geschwint/AEG_Micromat/Original Hardware/Control Comp. Side 2.jpg

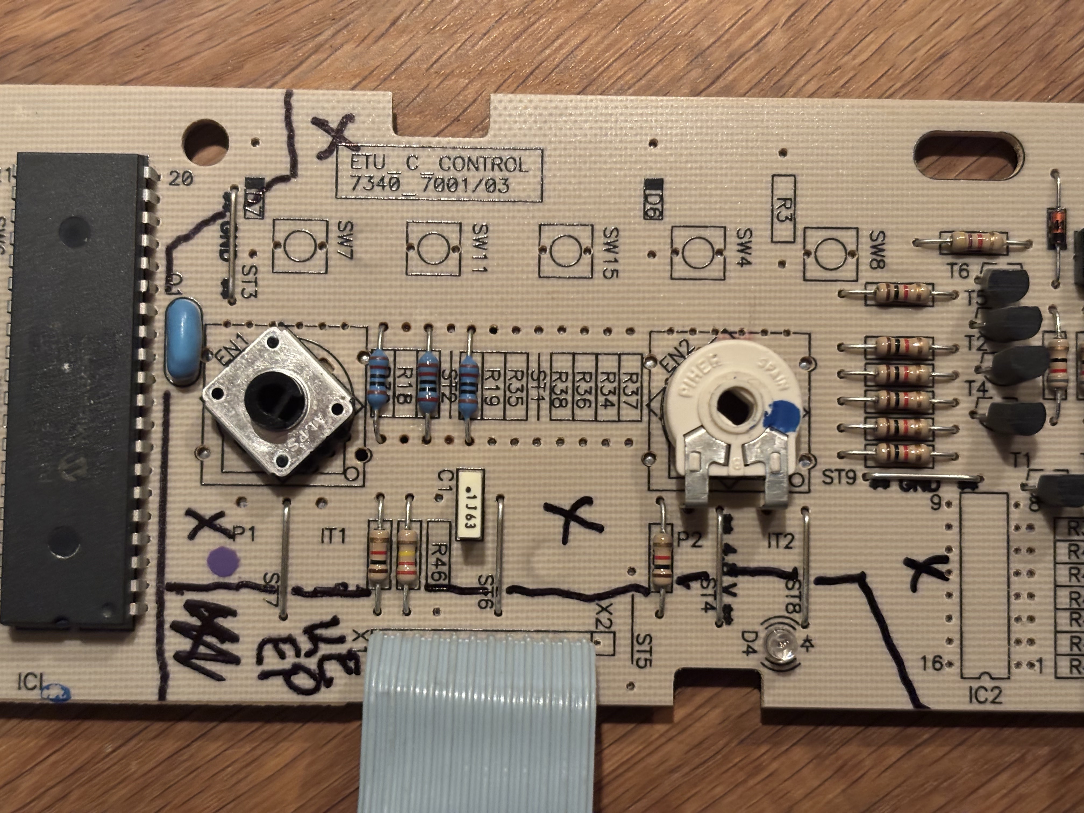
Original Hardware/Control Comp. Side 2.jpg
