geschwint/AEG_Micromat/Original Hardware/Panel.jpg

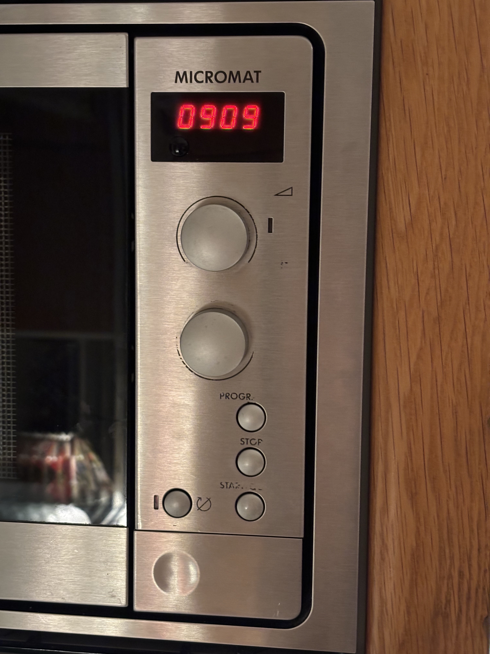
Original Hardware/Panel.jpg
