geschwint/AEG_Micromat/AboutTheMicro.jpg

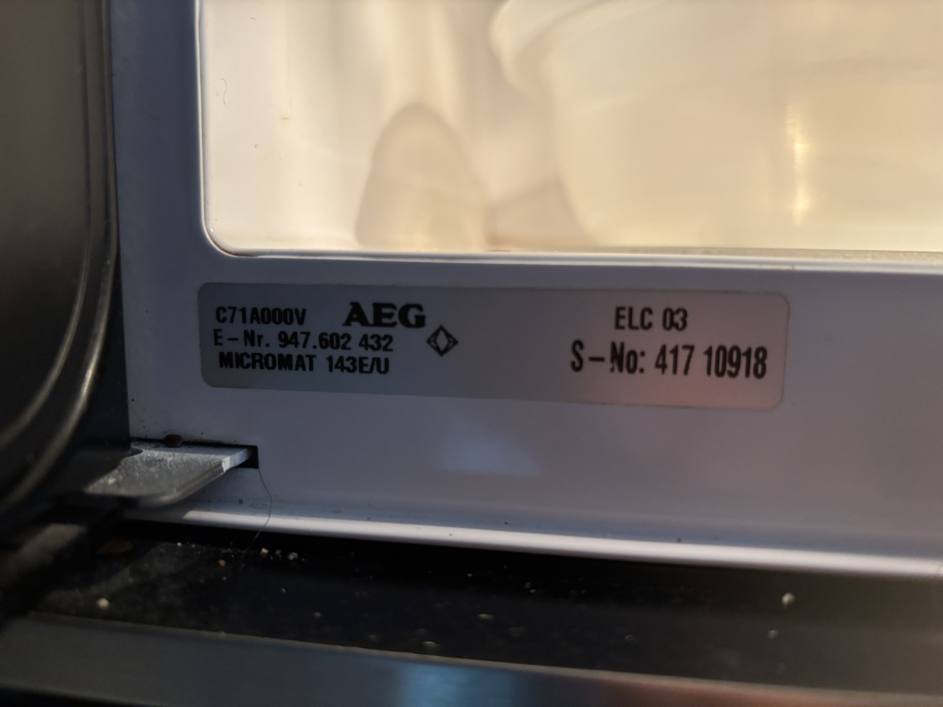
AboutTheMicro.jpg
