geschwint/AEG_Micromat/Original Hardware/Backside Panel Display, Encoder and Pot.jpg

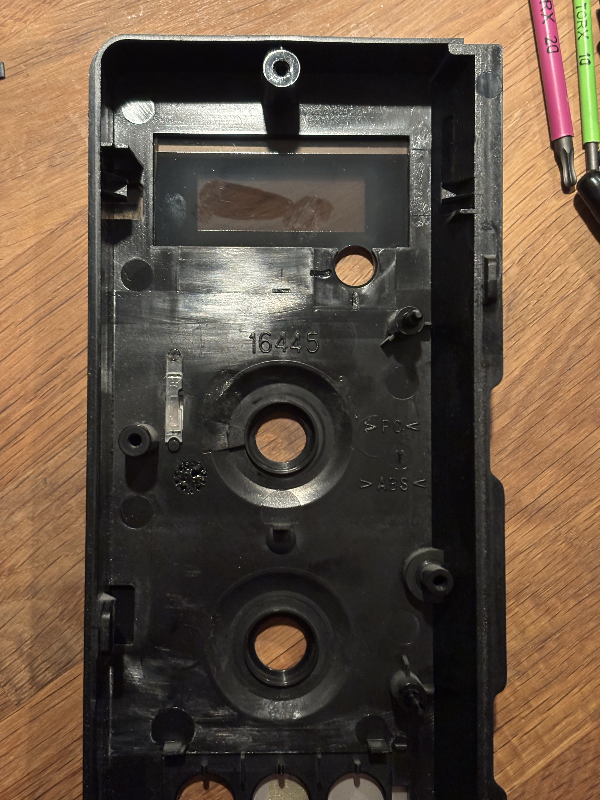
Original Hardware/Backside Panel Display, Encoder and Pot.jpg
