geschwint/AEG_Micromat/Original Hardware/Bakside Panel Buttons.jpg

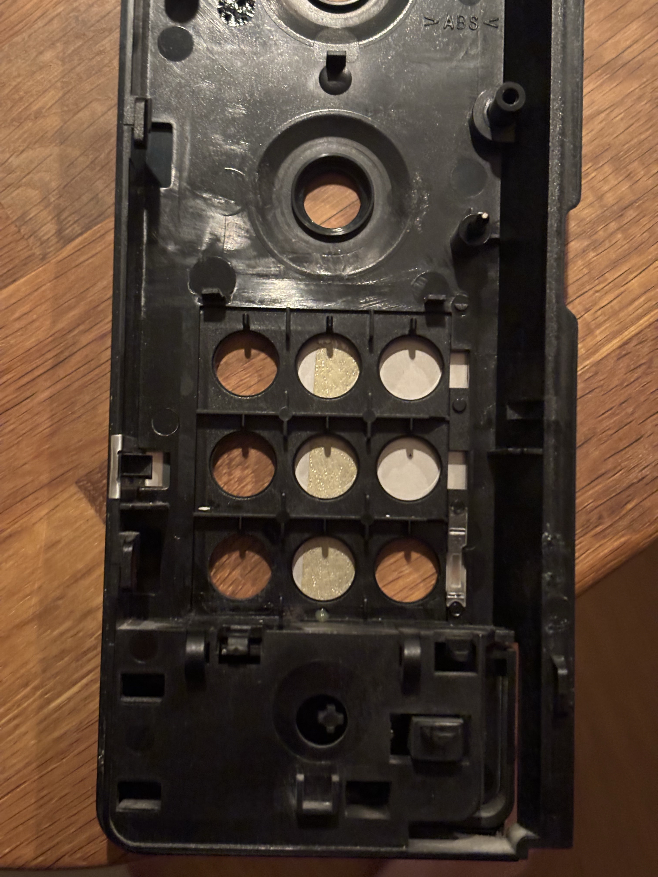
Original Hardware/Bakside Panel Buttons.jpg
