geschwint/AEG_Micromat/Original Hardware/Cables.jpg

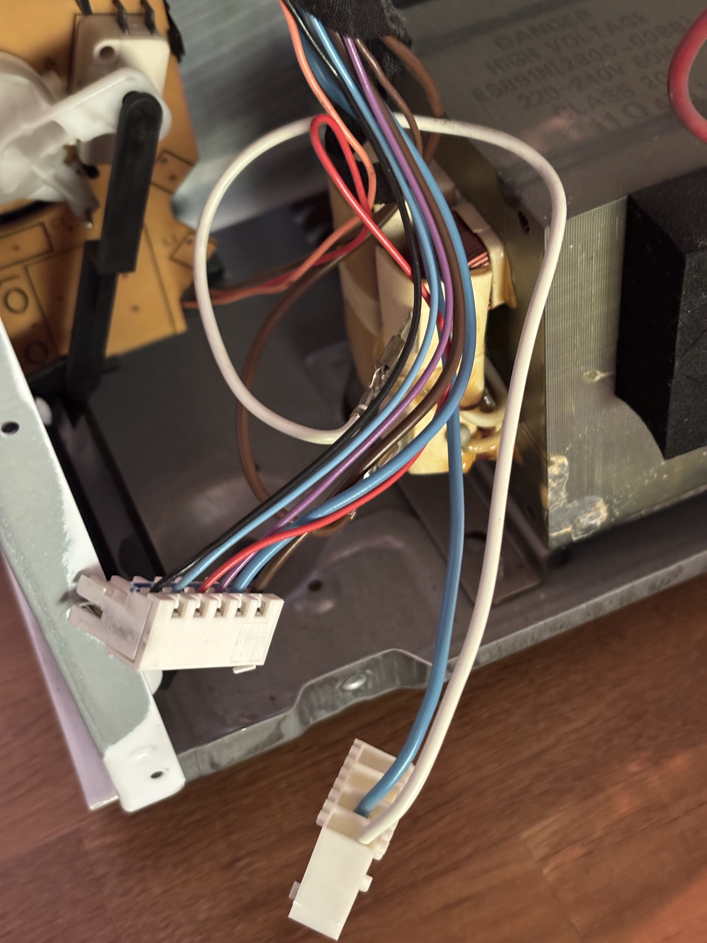
Original Hardware/Cables.jpg
