geschwint/AEG_Micromat/Original Hardware/Control Comp. Side 1.jpg

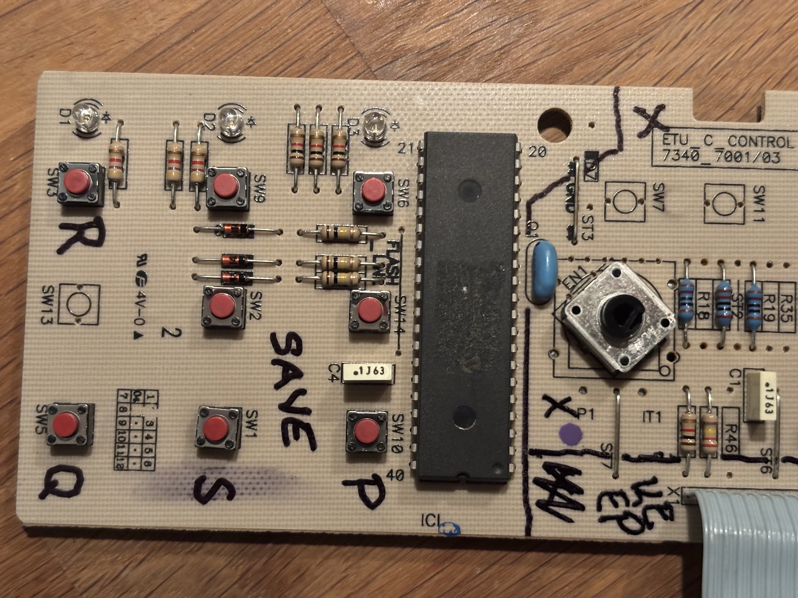
Original Hardware/Control Comp. Side 1.jpg
