geschwint/AEG_Micromat/Original Hardware/Control Comp. Side 3.jpg

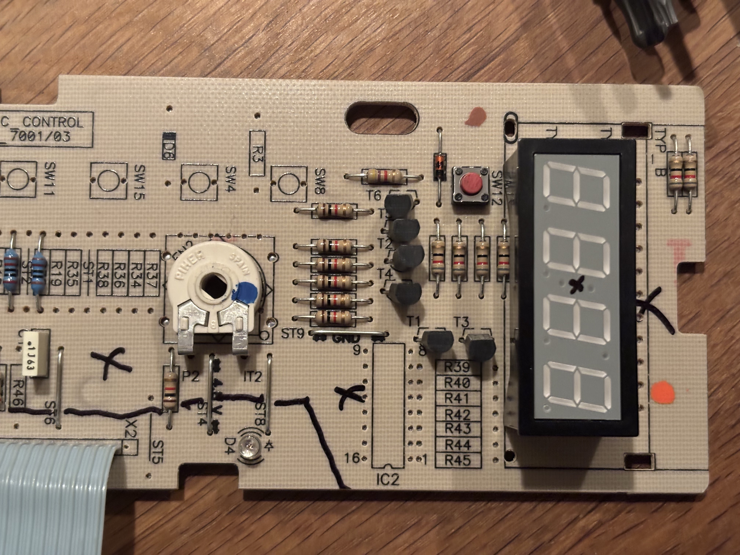
Original Hardware/Control Comp. Side 3.jpg
