geschwint/AEG_Micromat/Original Hardware/Control PCB Side 1.jpg

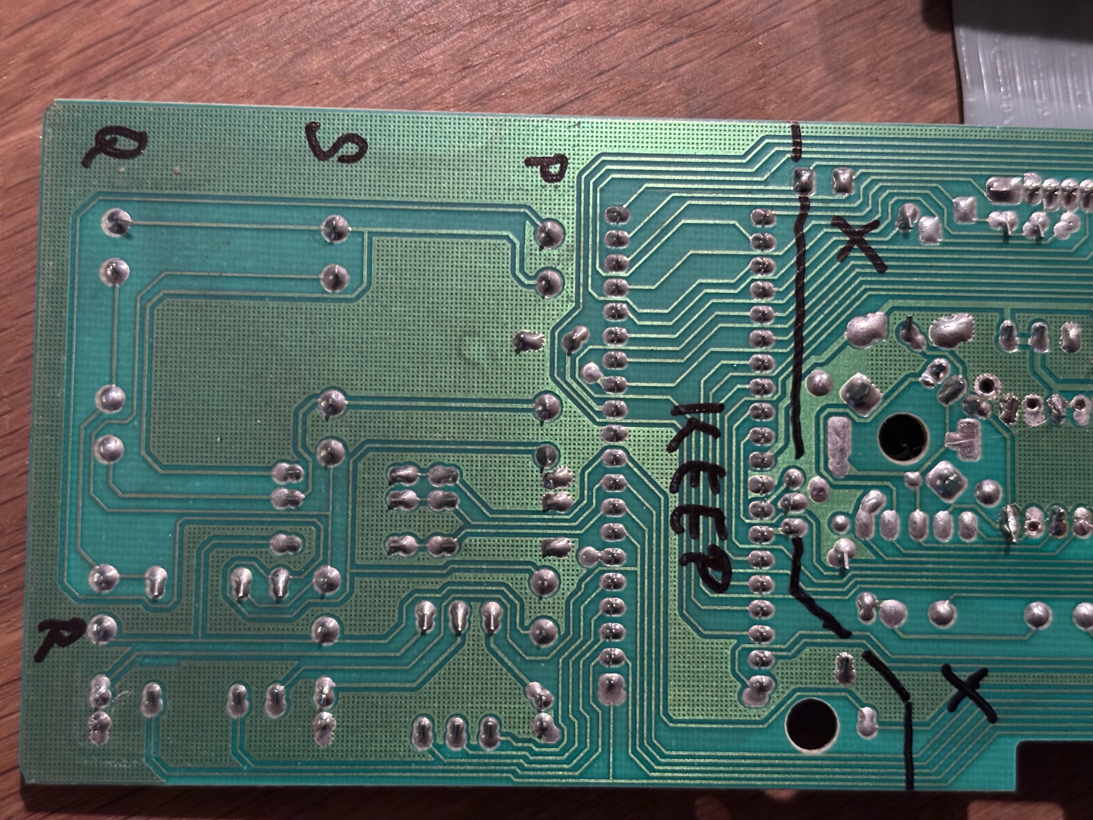
Original Hardware/Control PCB Side 1.jpg
