geschwint/AEG_Micromat/Original Hardware/Control PCB Side 2.jpg

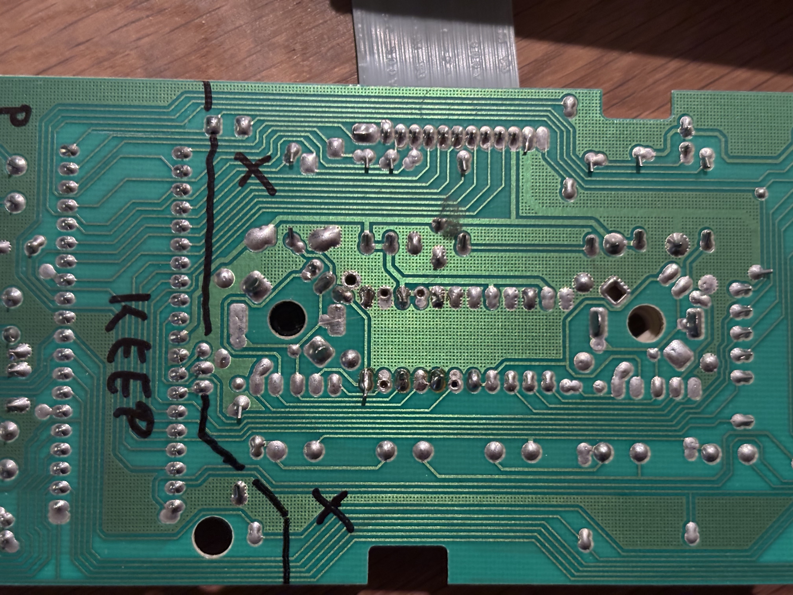
Original Hardware/Control PCB Side 2.jpg
