geschwint/AEG_Micromat/Original Hardware/Control PCB Side 3.jpg

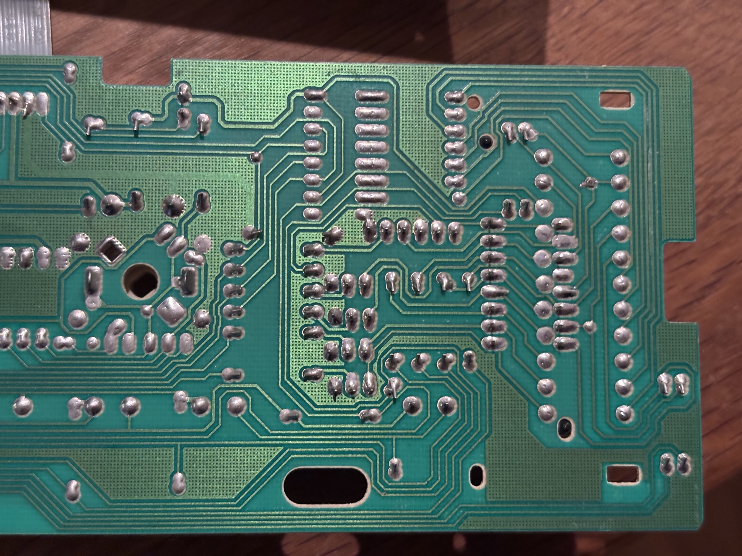
Original Hardware/Control PCB Side 3.jpg
