geschwint/AEG_Micromat/Original Hardware/Fan.jpg

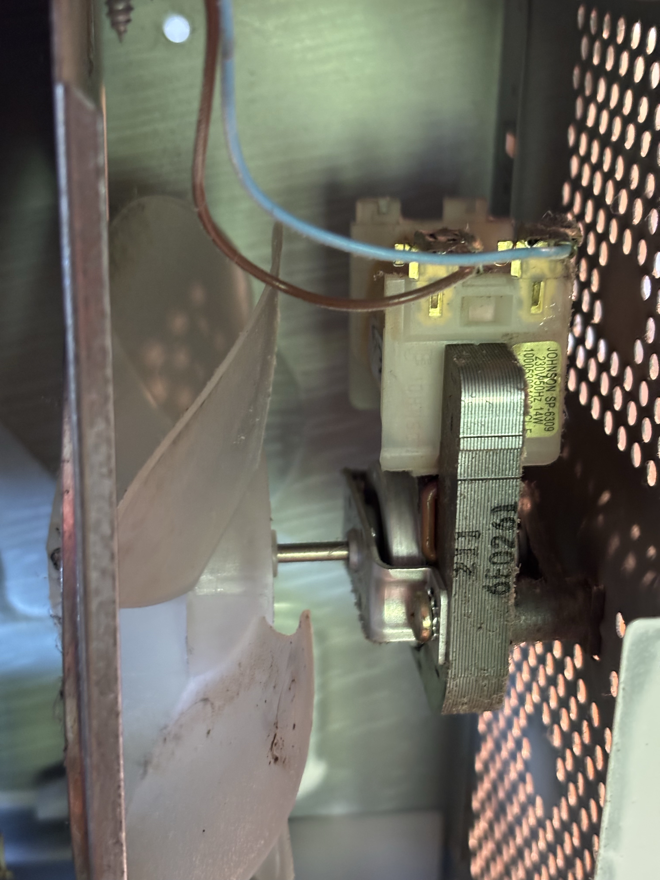
Original Hardware/Fan.jpg
