geschwint/AEG_Micromat/Original Hardware/Incoming and Noise Supressor.jpg

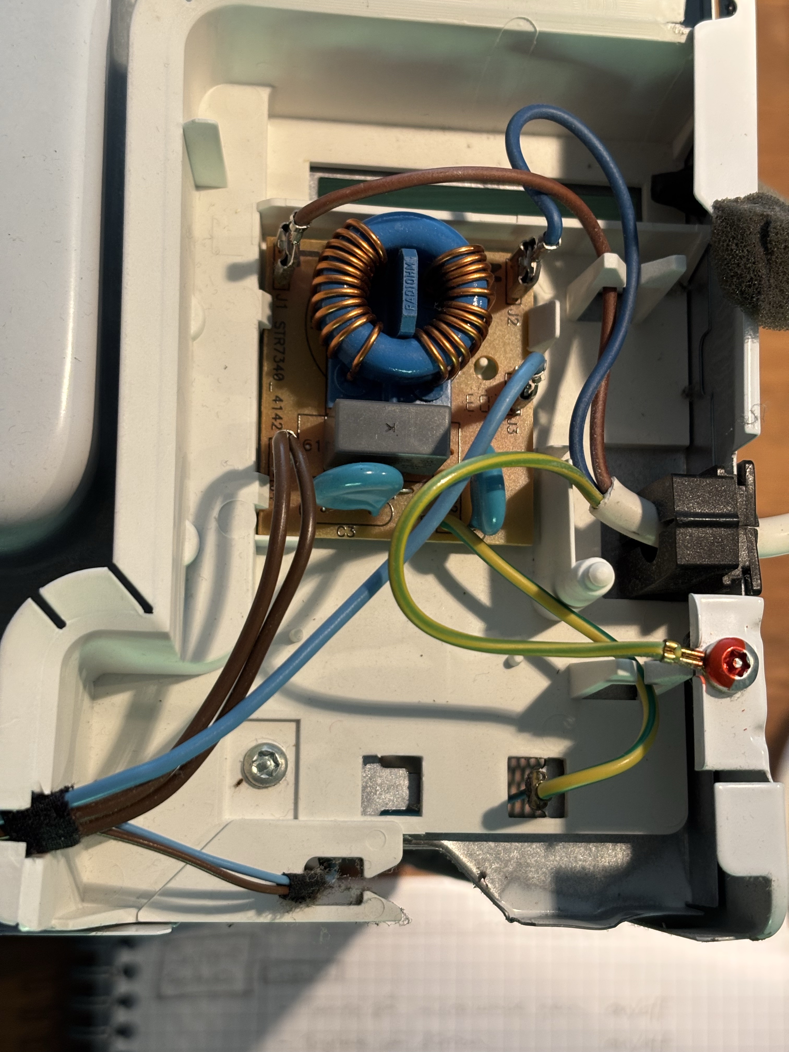
Original Hardware/Incoming and Noise Supressor.jpg
