geschwint/AEG_Micromat/Original Hardware/Light.jpg

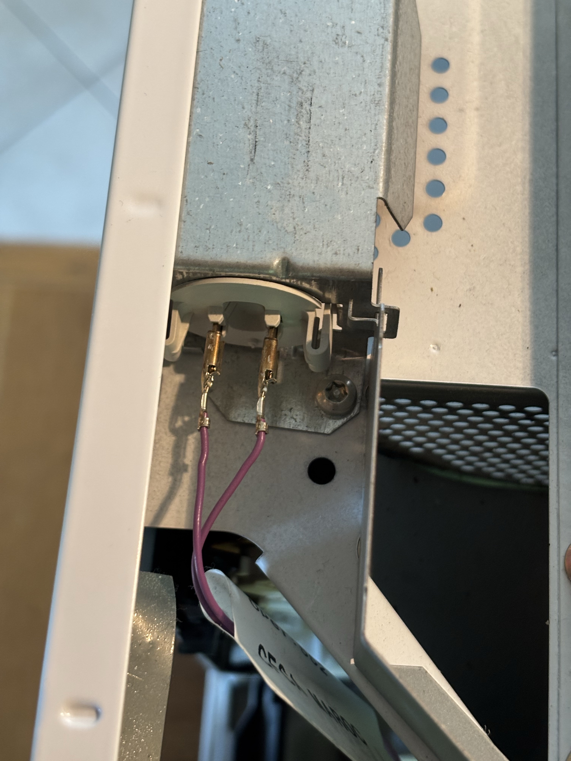
Original Hardware/Light.jpg
