geschwint/AEG_Micromat/Original Hardware/Magnetron.jpg

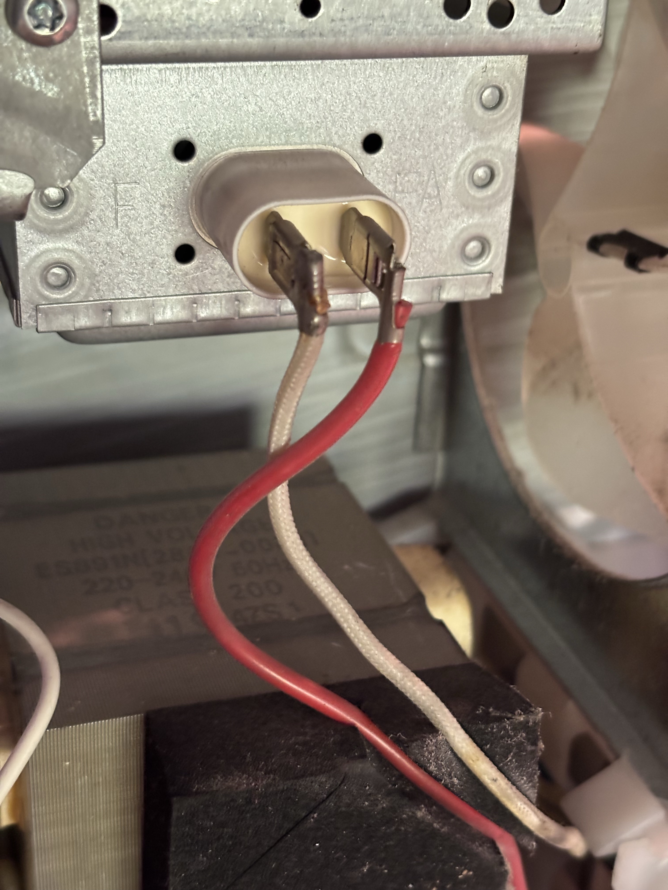
Original Hardware/Magnetron.jpg
