geschwint/AEG_Micromat/Original Hardware/Micro Oven Front.jpg

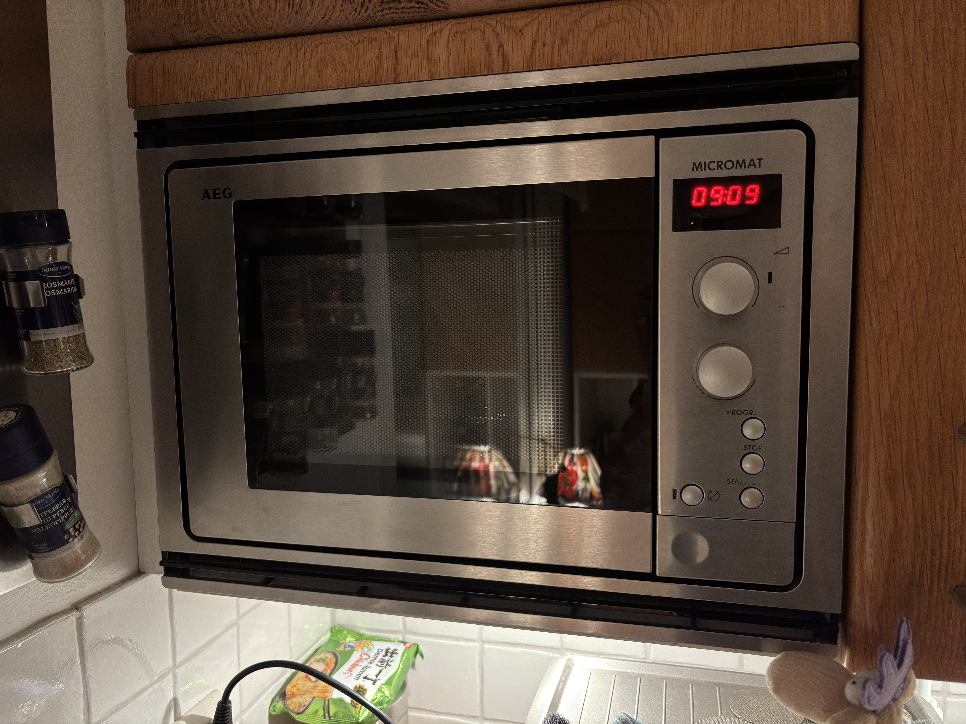
Original Hardware/Micro Oven Front.jpg
