geschwint/AEG_Micromat/Original Hardware/Overlays/Control overlay keys.jpg

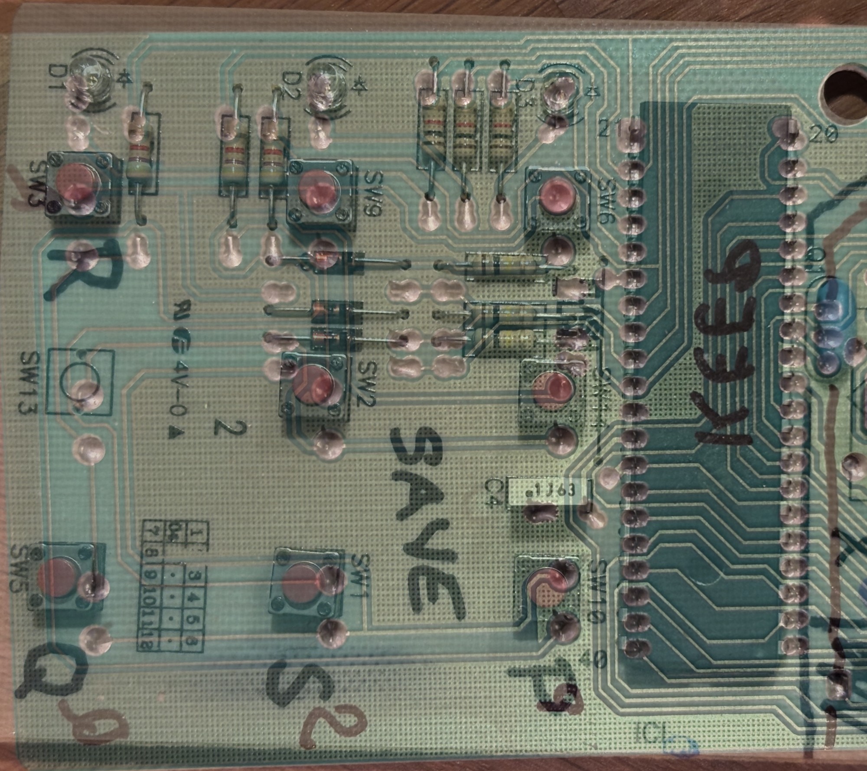
Original Hardware/Overlays/Control overlay keys.jpg
