geschwint/AEG_Micromat/Original Hardware/Overlays/Power copper relay end enhanced.jpg

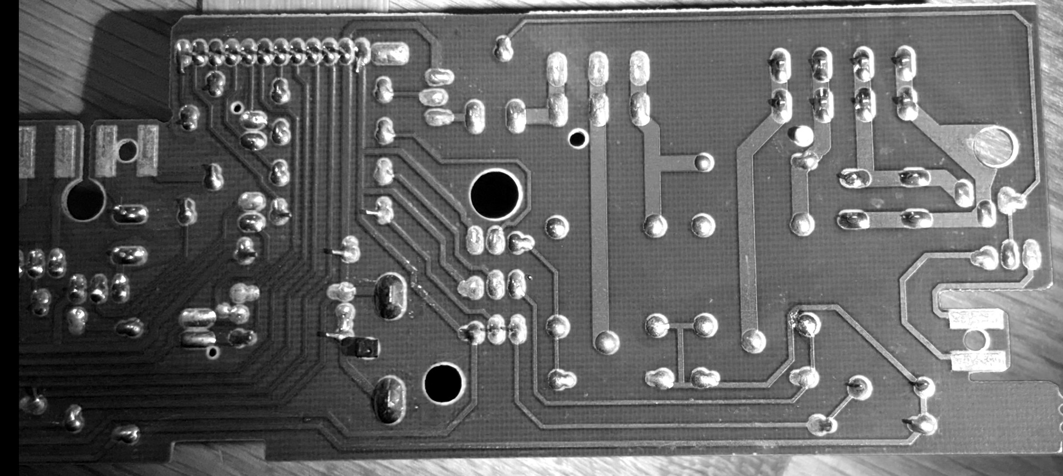
Original Hardware/Overlays/Power copper relay end enhanced.jpg
