geschwint/AEG_Micromat/Original Hardware/Overlays/Power copper supply end enhanced.jpg

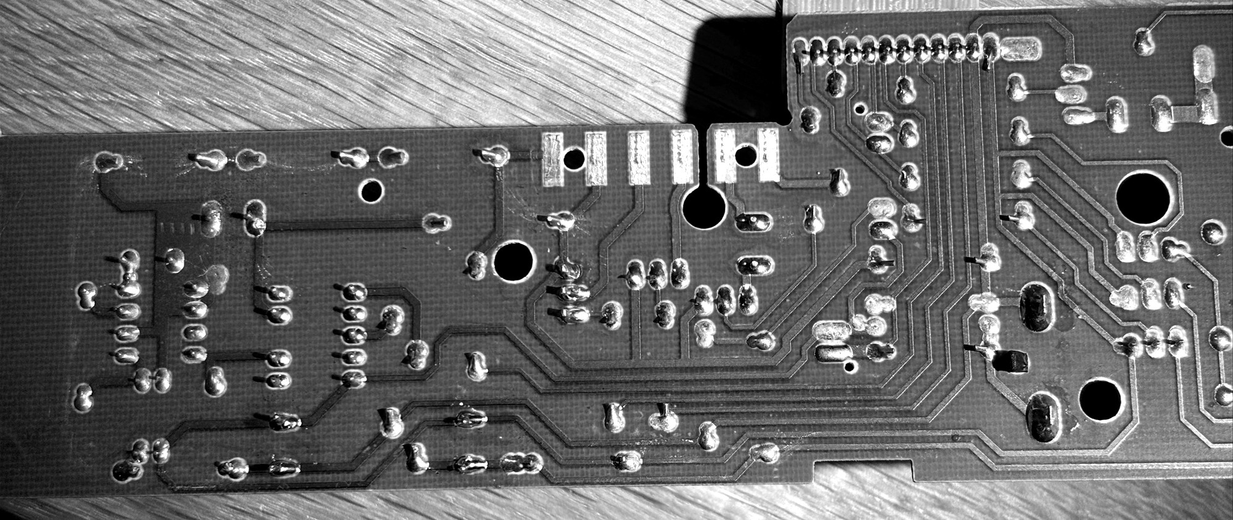
Original Hardware/Overlays/Power copper supply end enhanced.jpg
