geschwint/AEG_Micromat/Original Hardware/Overlays/Power overlay relay end.jpg

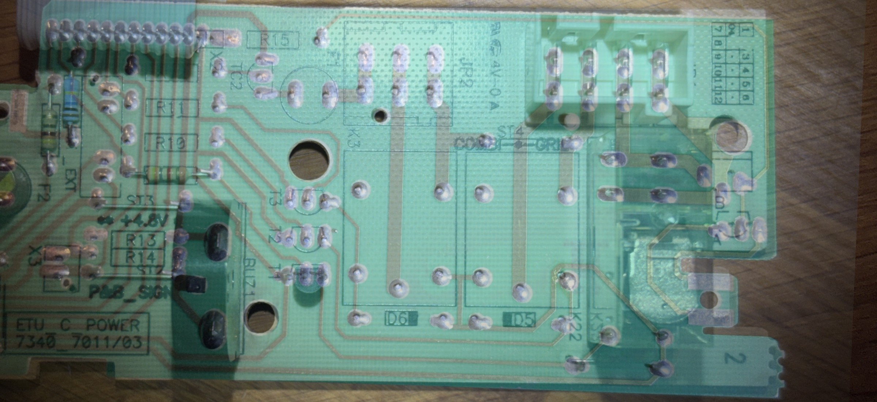
Original Hardware/Overlays/Power overlay relay end.jpg
