geschwint/AEG_Micromat/Original Hardware/Overlays/Power overlay supply end.jpg

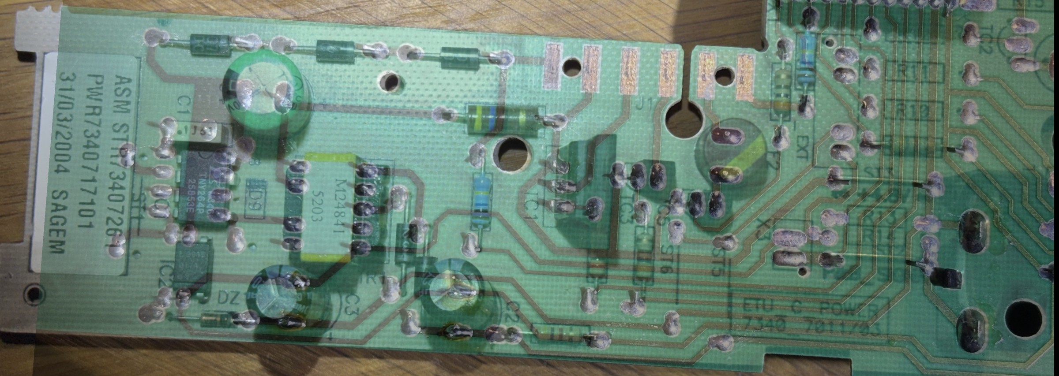
Original Hardware/Overlays/Power overlay supply end.jpg
