geschwint/AEG_Micromat/Original Hardware/Overlays/Safety copper enhanced.jpg

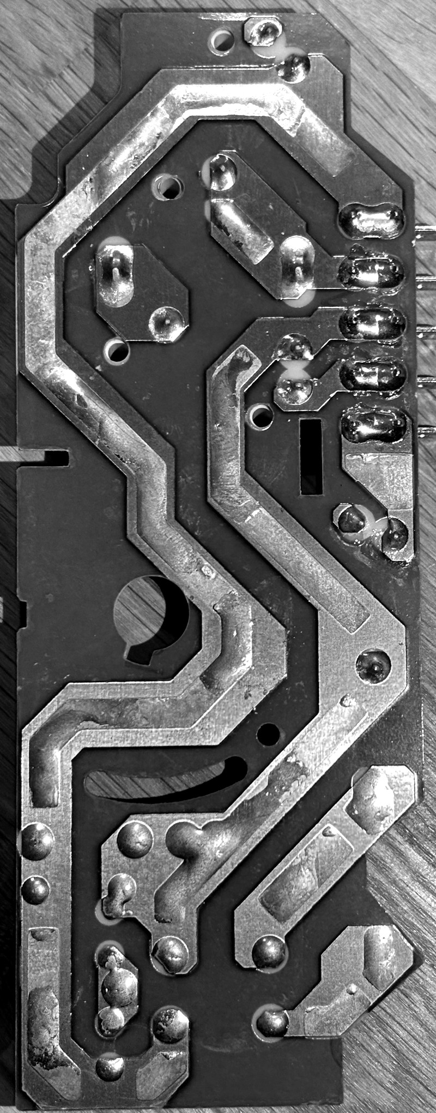
Original Hardware/Overlays/Safety copper enhanced.jpg
