geschwint/AEG_Micromat/Original Hardware/Overlays/Safety overlay.jpg

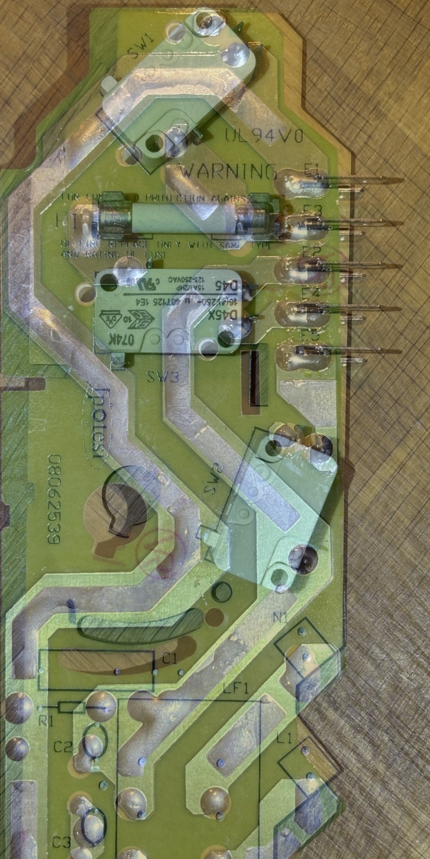
Original Hardware/Overlays/Safety overlay.jpg
