geschwint/AEG_Micromat/Original Hardware/Panel Control Lower Locations.jpg

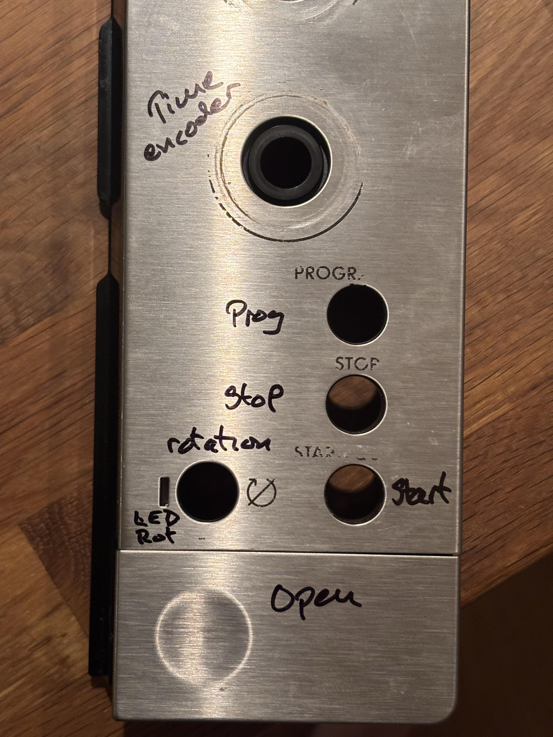
Original Hardware/Panel Control Lower Locations.jpg
