geschwint/AEG_Micromat/Original Hardware/Panel Control Upper Locations.jpg

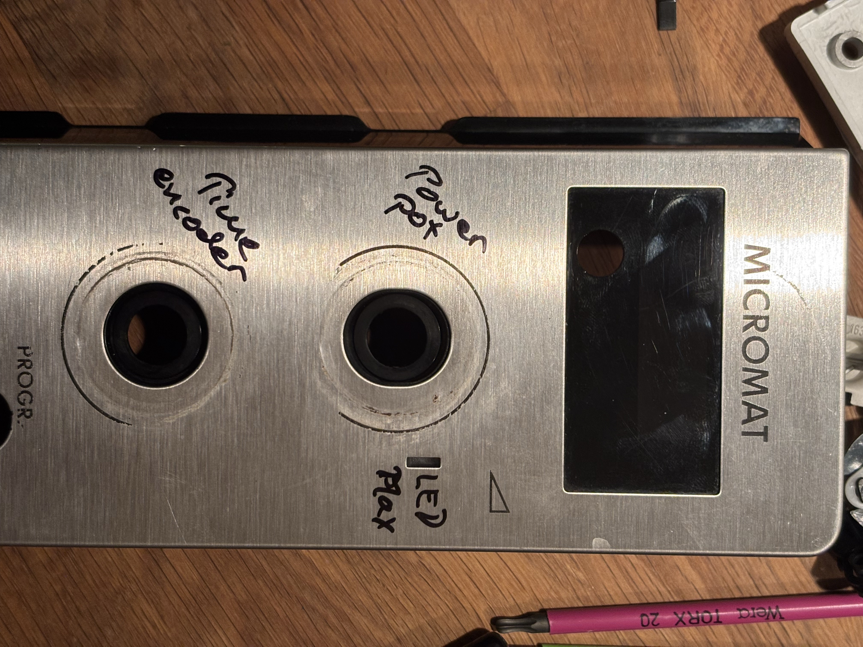
Original Hardware/Panel Control Upper Locations.jpg
