geschwint/AEG_Micromat/Original Hardware/Panel Upper.jpg

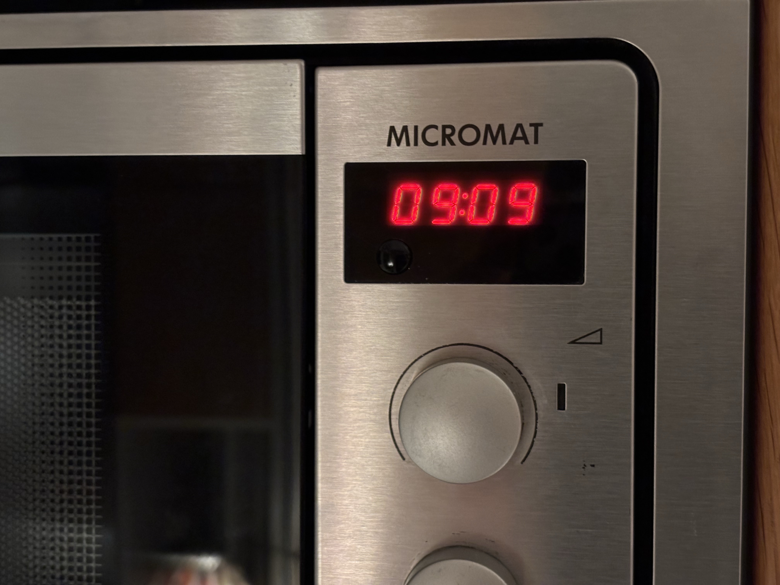
Original Hardware/Panel Upper.jpg
