geschwint/AEG_Micromat/Original Hardware/Power Comp. Side 1.jpg

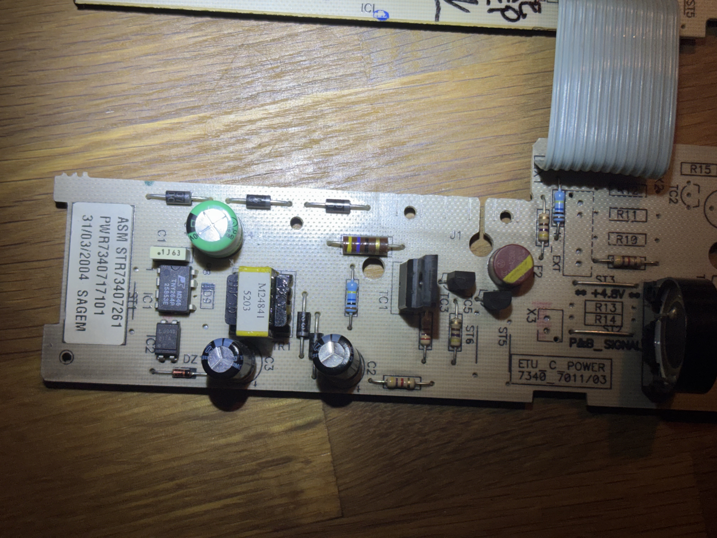
Original Hardware/Power Comp. Side 1.jpg
