geschwint/AEG_Micromat/Original Hardware/Power Comp. Side 2.jpg

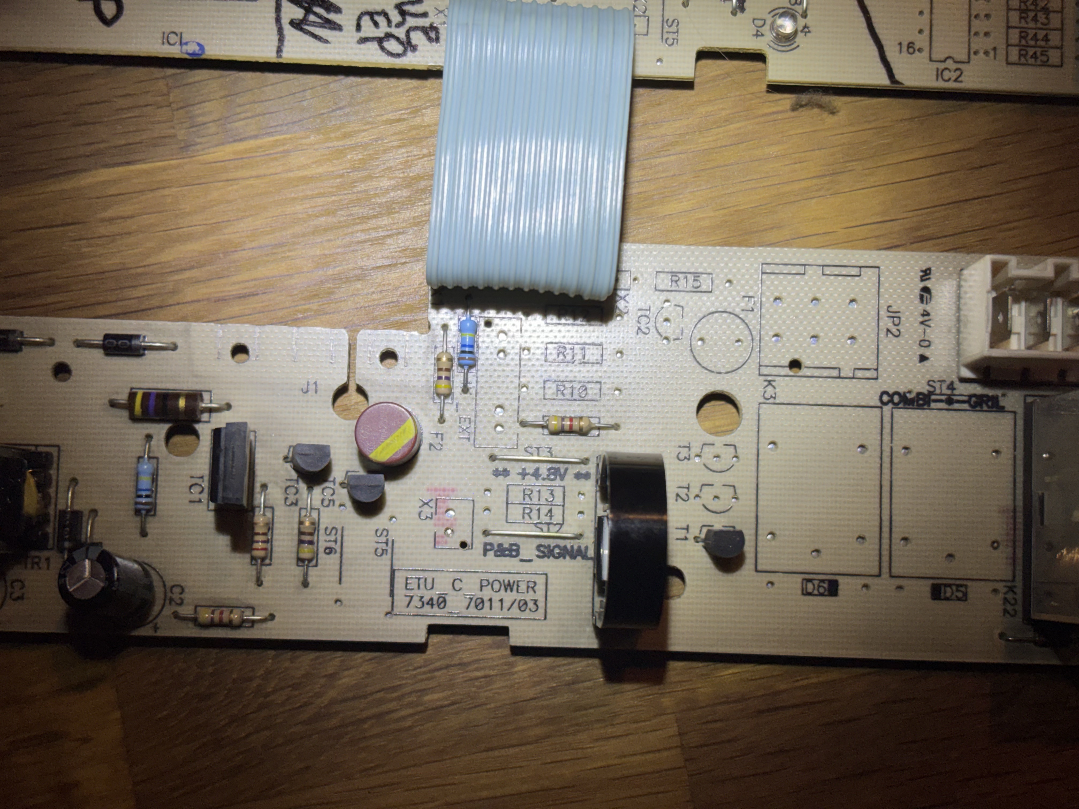
Original Hardware/Power Comp. Side 2.jpg
