geschwint/AEG_Micromat/Original Hardware/Power Comp. Side 3.jpg

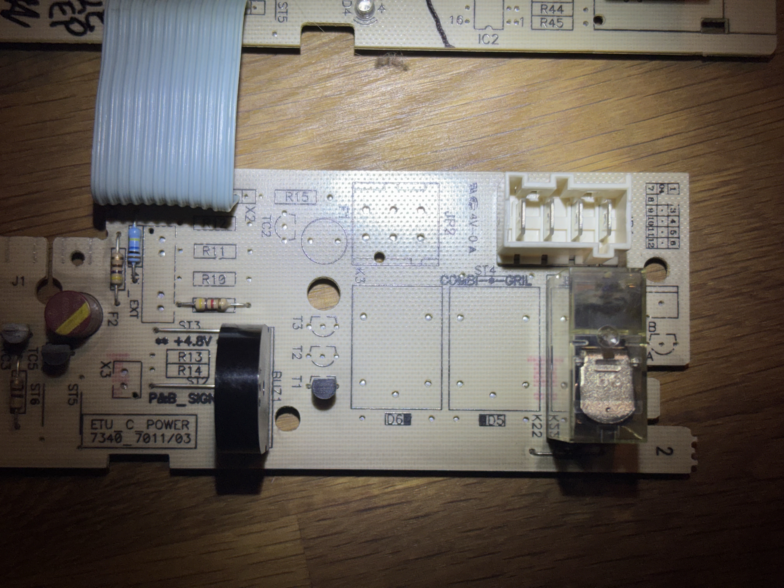
Original Hardware/Power Comp. Side 3.jpg
