geschwint/AEG_Micromat/Original Hardware/Power PCB Side 1.jpg

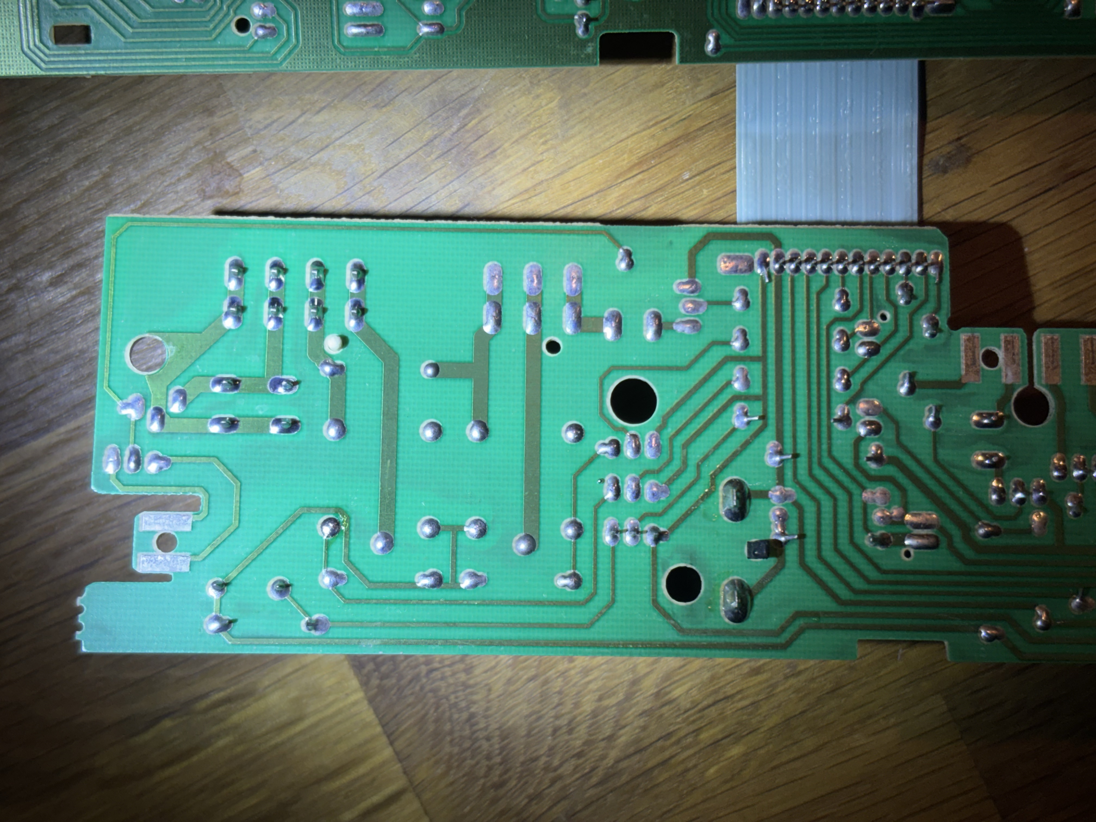
Original Hardware/Power PCB Side 1.jpg
