geschwint/AEG_Micromat/Original Hardware/Power PCB Side 2.jpg

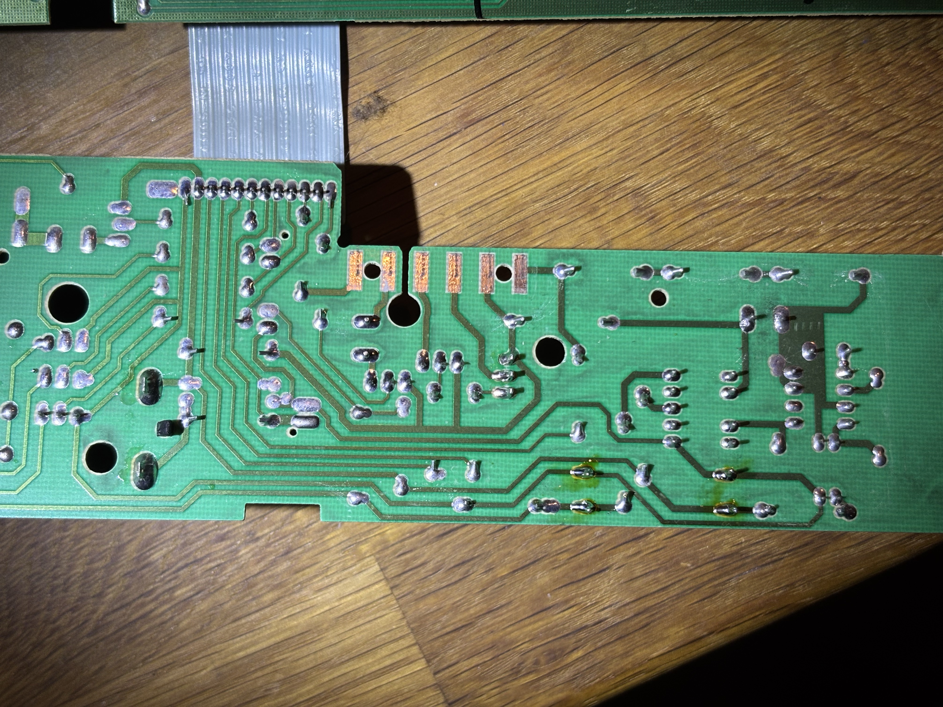
Original Hardware/Power PCB Side 2.jpg
