geschwint/AEG_Micromat/Original Hardware/Relay Magnetron.jpg

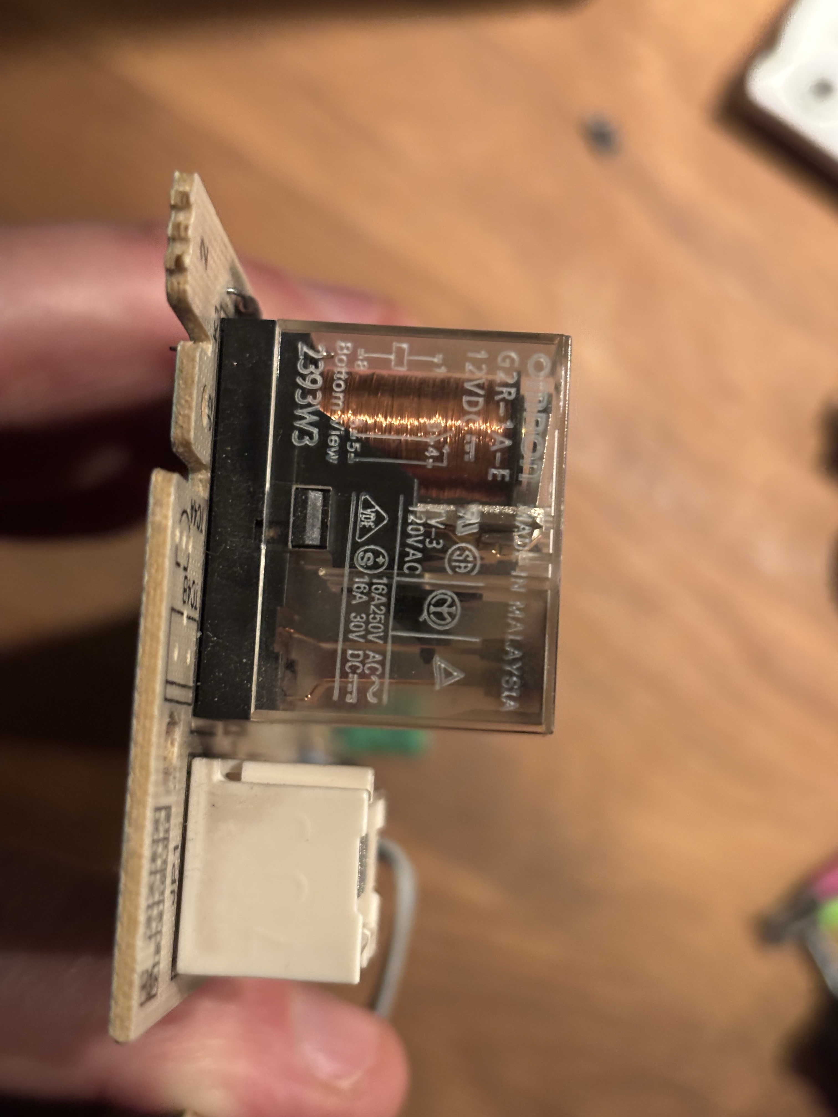
Original Hardware/Relay Magnetron.jpg
