geschwint/AEG_Micromat/Original Hardware/Rotation Motor.jpg

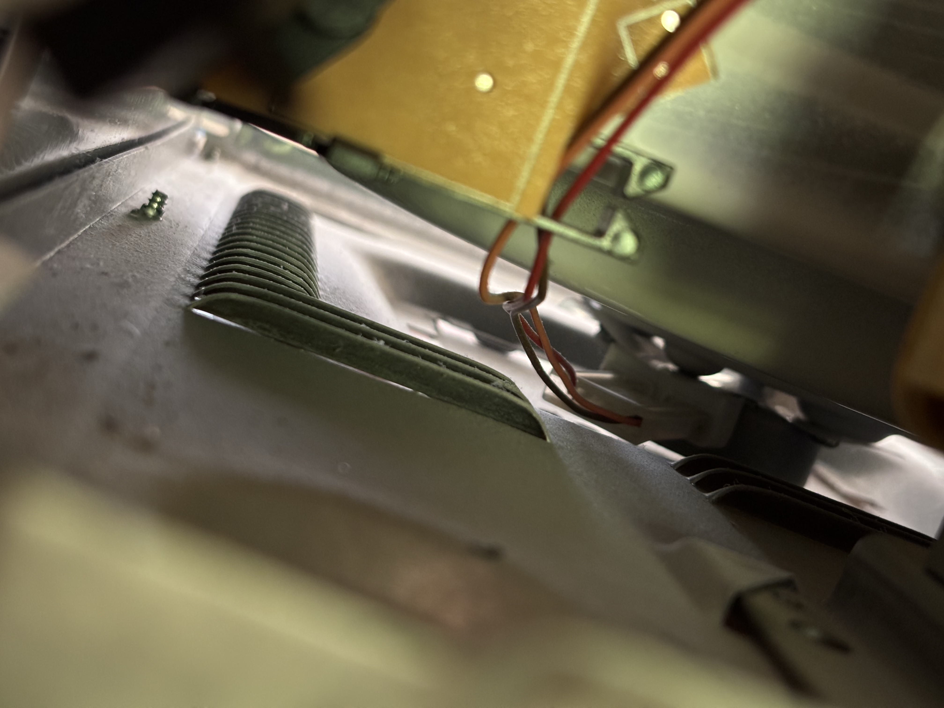
Original Hardware/Rotation Motor.jpg
