geschwint/AEG_Micromat/Original Hardware/Safety Comp. Side.jpg

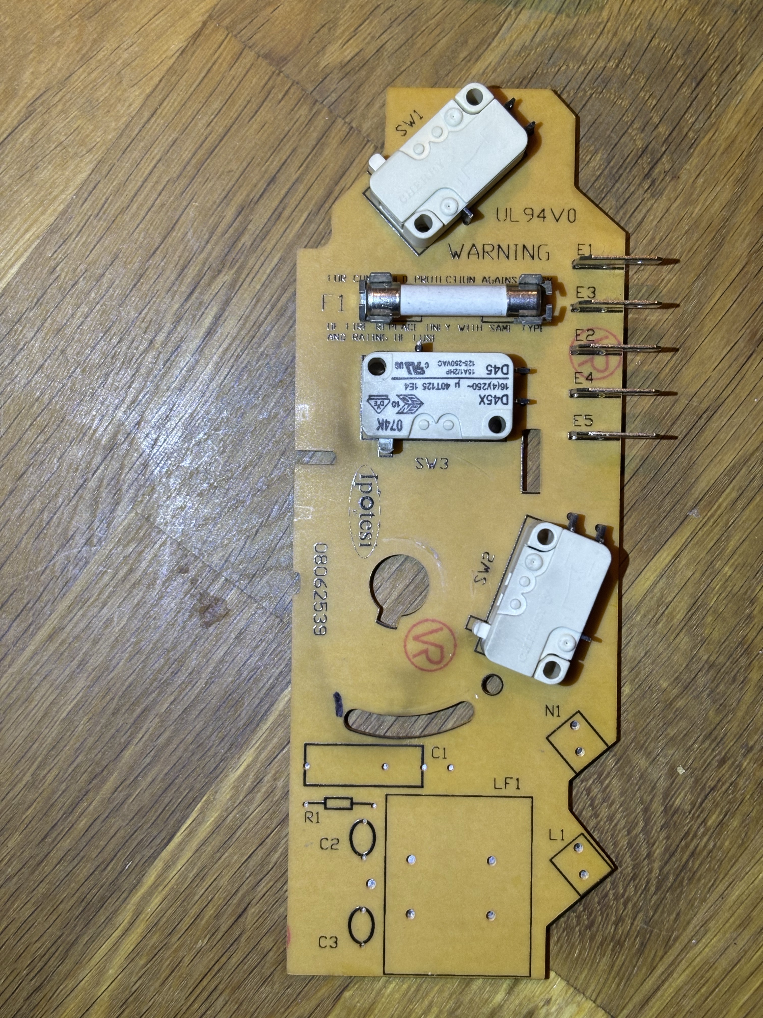
Original Hardware/Safety Comp. Side.jpg
