geschwint/AEG_Micromat/Original Hardware/Safety PCB Side.jpg

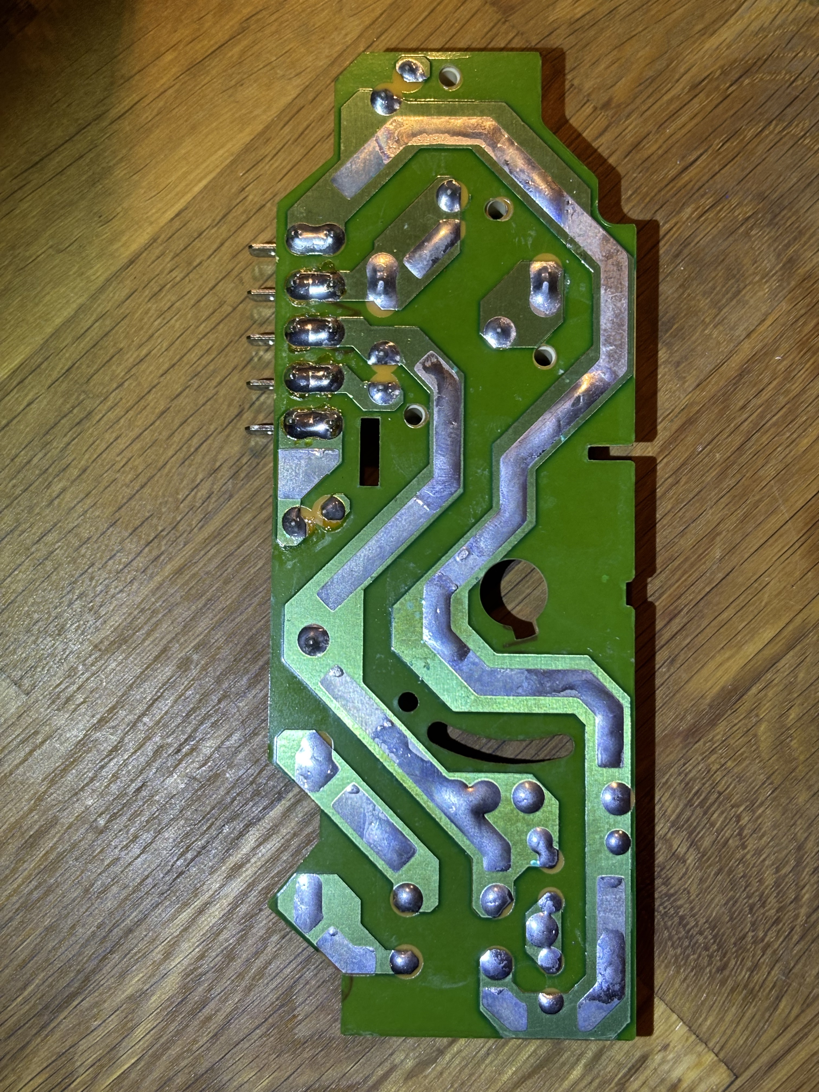
Original Hardware/Safety PCB Side.jpg
