geschwint/AEG_Micromat/Original Hardware/Switch Board 1.jpg

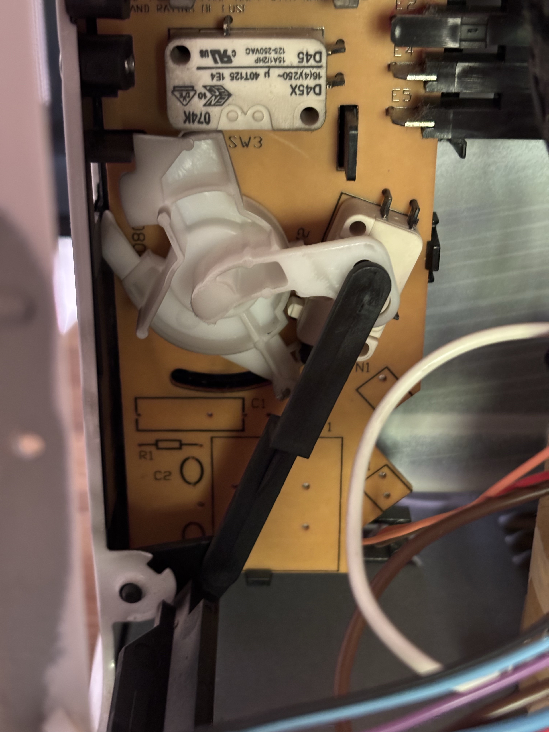
Original Hardware/Switch Board 1.jpg
