geschwint/AEG_Micromat/Original Hardware/Switch Board 2.jpg

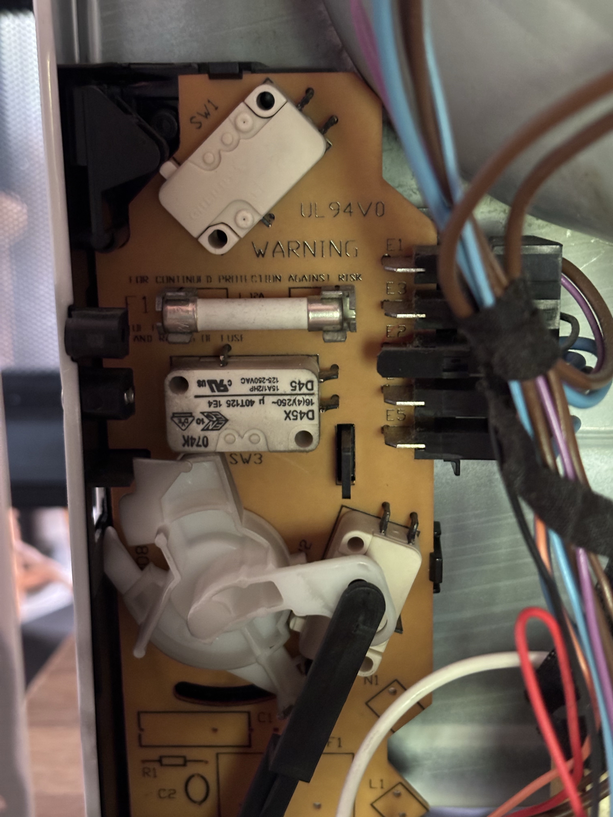
Original Hardware/Switch Board 2.jpg
