geschwint/AEG_Micromat/Original Hardware/Switch Board Connector.jpg

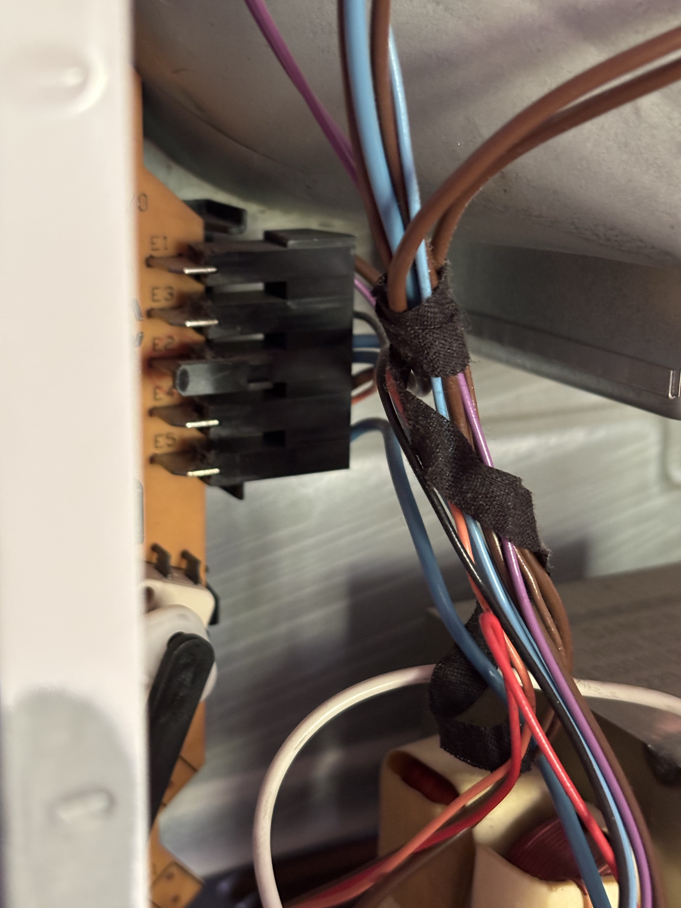
Original Hardware/Switch Board Connector.jpg
