geschwint/AEG_Micromat/Original Hardware/Temperature Switch.jpg

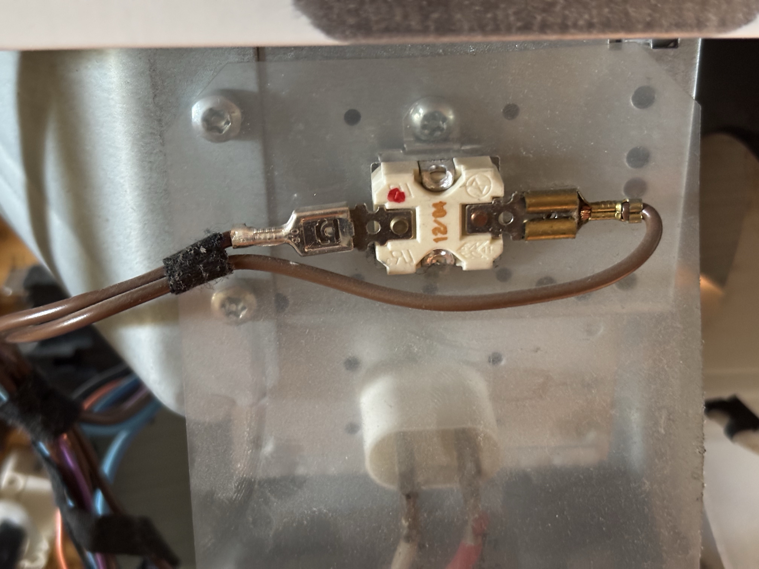
Original Hardware/Temperature Switch.jpg
