geschwint/AEG_Micromat/Original Hardware/Transformer and Cables.jpg

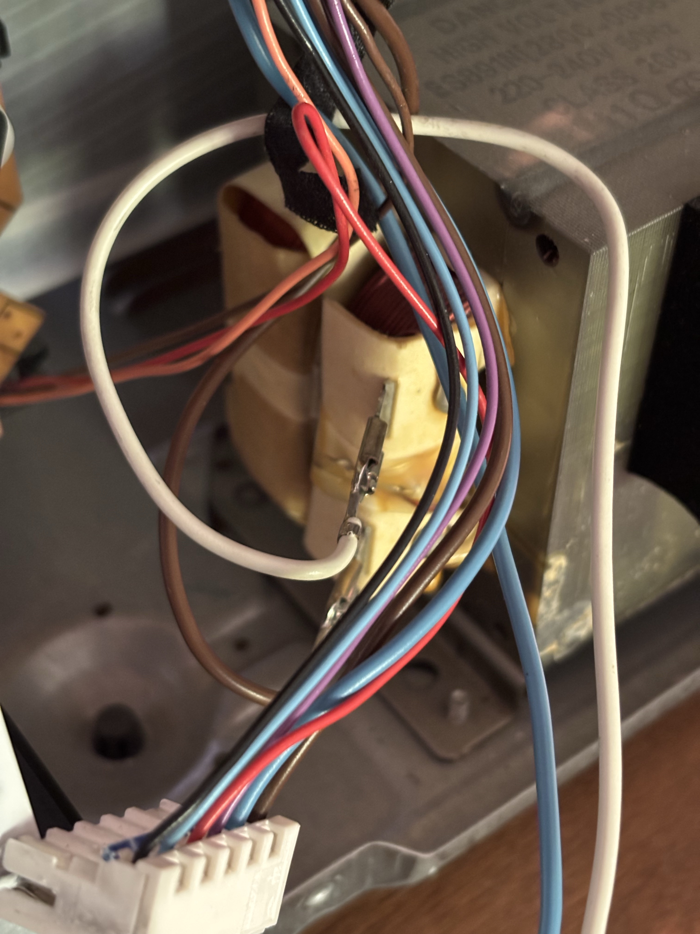
Original Hardware/Transformer and Cables.jpg
