geschwint/AEG_Micromat/Micromat/Micromat.ino

// AEG Micromat 143 replacement controller — main sketch.
// Waveshare ESP32-S3-Touch-LCD-2. See PLAN.md and HARDWARE.md.
//
// Everything is non-blocking: each module has an update(now) that checks the
// time and does a little work, and loop() calls them all on every pass.
// No delay() anywhere in the control path. A loop watchdog restarts the board
// (all outputs OFF) if loop() ever stalls.
#include <Arduino_GFX_Library.h>
#include "crash_report.h"
#include "debug_log.h"
#include <Wire.h>
#include "config.h"
#include "outputs.h"
#include "buzzer.h"
#include "door.h"
#include "oven.h"
#include "clock.h"
#include "inputs.h"
#include "app.h"
#include "eggs.h"
#include "settings.h"
#include "about.h"
#include "fw_update.h"
#include "wifi_creds.h"
#include "wifi_setup.h"
#include "wifi_time.h"
#include "ui.h"
#include "console.h"
#include "perf.h"
#include "touch_cst816.h"
#include <esp_heap_caps.h>

// FSPI: the SD card (debug_log.cpp) shares this bus and must use the same SPI peripheral.
Arduino_DataBus *lcdBus = new Arduino_ESP32SPI(PIN_LCD_DC, PIN_LCD_CS, PIN_LCD_SCLK, PIN_LCD_MOSI, PIN_LCD_MISO, FSPI);
Arduino_GFX *gfx = new Arduino_ST7789(lcdBus, -1 /* no reset pin */, 1 /* landscape */, true /* IPS */, 240, 320);

Outputs outputs;
Buzzer buzzer;
Door door;
Oven oven;
Clock rtcClock;
Inputs inputs;
App app;
WifiTime wifiTime;
LoopStats loopStats;

// Input events go to App, which decides what they mean on the current screen.
static void onInputEvent(InputEvent event, int32_t value) {
  app.onInput(event, value);
}

// A firmware transfer blocks loop() for 10-40 s; this keeps the safety-related
// modules and the display (progress) running meanwhile. The oven is idle then.
static void pumpDuringUpdate() {
  uint32_t now = millis();
  door.update(now);
  oven.update(now, door.closed());
  outputs.update(now, door.closed());
  buzzer.update(now);
  uiUpdate();
}

void setup() {
  crashReportBegin();  // records failed memory allocations (kept across a crash restart)
  outputs.begin();  // first: every output OFF
  pinMode(PIN_SD_CS, OUTPUT);  // SD card deselected, so it ignores the display's SPI traffic
  digitalWrite(PIN_SD_CS, HIGH);

  Serial.begin(115200);
  // With no reader on the PC, USB serial writes would otherwise wait up to
  // 100 ms each for buffer space, stalling loop(). Drop the log text instead.
  Serial.setTxTimeoutMs(0);
  Log.printf("Micromat controller starting (firmware %s, build %s, %s)\n", FIRMWARE_VERSION,
                FirmwareUpdate::version(), FirmwareUpdate::runningSlot());
  crashReportLog(false);  // reset reason; the last crash, if one was saved

  loadSettings();  // before anything that uses them (buzzer volume, UI language, ...)
  loadEggs();      // easter eggs kept in flash (the end melody)
  credsBegin();    // Wi-Fi network store; also stops the Wi-Fi driver keeping a plain-text copy
  buzzer.begin();
  door.begin();

  gfx->begin();
  gfx->fillScreen(RGB565_BLACK);

  bool touchOk = touchBegin(Wire, PIN_I2C_SDA, PIN_I2C_SCL, SCREEN_W, SCREEN_H);  // also starts Wire
  rtcClock.begin();
  Log.begin(rtcClock);  // debug log on the SD card, if on in Settings (after the display: shared SPI bus)
  Log.printf("touch %s, RTC %s, door %s\n", touchOk ? "ok" : "FAILED", rtcClock.valid() ? "ok" : "not valid",
                door.simulated() ? "simulated" : "sensor");

  oven.begin(outputs, buzzer);
  wifiTime.begin(rtcClock);
  app.begin(oven, door, buzzer, rtcClock, wifiTime);
  inputs.begin(onInputEvent);
  uiBegin(gfx, app, oven, door, rtcClock, outputs, inputs, wifiTime);  // also sets up the backlight PWM
  firmwareUpdate.setProgressHook(pumpDuringUpdate);

  enableLoopWDT();
  Log.println("ready (send any unknown text for help)");
}

void loop() {
  static bool lastDoorClosed = door.closed();
  uint32_t startUs = micros();
  uint32_t now = millis();

  door.update(now);
  if (door.closed() != lastDoorClosed) {
    lastDoorClosed = door.closed();
    oven.doorChanged(lastDoorClosed, now);
  }

  inputs.update(now);                  // panel buttons, encoder, pot -> events -> App
  app.update(now);                     // touch, dimming, menu timeout
  oven.update(now, door.closed());     // decides what it wants on
  if (app.dimmed()) {                  // panel LEDs sleep with the display
    outputs.request(OUT_LED_ROTATE, false);
    outputs.request(OUT_LED_MAXPOWER, false);
  }
  outputs.update(now, door.closed());  // applies interlocks, drives pins
  buzzer.update(now);
  rtcClock.update(now);
  wifiSetup.update(now);               // Wi-Fi setup network + web page, while that screen is open
  firmwareUpdate.update(now);          // firmware update page / OTA, while that screen is open
  firmwareUpdate.confirmIfHealthy(now);  // a new firmware confirms itself after 30 s
  Log.update(now);                     // debug log: buffered text to the SD card every few seconds
  static uint32_t lastMemLog = 0;      // free memory in the log now and then, so a leak shows up
  if (now - lastMemLog >= MEM_LOG_MS) {
    lastMemLog = now;
    Log.printf("[%7lu] mem: internal %u free, largest %u, min ever %u | PSRAM %u free, largest %u\n", now,
               (unsigned)heap_caps_get_free_size(MALLOC_CAP_INTERNAL), (unsigned)heap_caps_get_largest_free_block(MALLOC_CAP_INTERNAL),
               (unsigned)heap_caps_get_minimum_free_size(MALLOC_CAP_INTERNAL), (unsigned)heap_caps_get_free_size(MALLOC_CAP_SPIRAM),
               (unsigned)heap_caps_get_largest_free_block(MALLOC_CAP_SPIRAM));
  }
  wifiTime.update(now);                // clock over Wi-Fi (NTP), when enabled
  consoleUpdate(oven, door, rtcClock, outputs, inputs, wifiTime);
  uiUpdate();
  loopStats.record(micros() - startUs);
}
