geschwint/AEG_Micromat/Micromat/ui_text.h

// Every text shown on screen, looked up by id in the table for the language
// chosen in Settings (English, Svenska, Deutsch, Français, Español). Serial/log text is not translated. Texts are UTF-8; the
// UI fonts (Tiny TTF Montserrat) include å, ä, ö.
#pragma once
#include <Arduino.h>

enum class Str : uint8_t {
  Open,
  End,
  Paused,
  Timer,
  Menu,
  Settings,
  Defrost,
  Programs,
  Clock,
  SetTime,
  AutoTime,
  Brightness,
  DimLevel,
  DimDelay,
  Never,
  Sound,
  KeyClicks,
  Volume,
  Low,
  Medium,
  High,
  On,
  Off,
  Language,
  Meat,
  Poultry,
  Fish,
  Bread,
  ReheatPlate,
  Beverage,
  Popcorn,
  SoftenButter,
  MeltChocolate,
  Favourite,
  SaveFavourite,
  Empty,
  SetTimeFirst,
  Saved,
  TurnFood,
  NoWifi,
  MenuHint,
  EditHint,
  ClockHint,
  Service,
  ServiceHint,
  // Wi-Fi menu and setup screen
  Wifi,
  Network,
  NotSet,
  ForgetNetwork,
  Forgotten,
  NoKey,
  WifiSetup,
  Password,
  Address,
  SetupScan,
  SetupPhone,
  SetupTesting,   // printf format, %s = network name
  SetupOk,
  SetupNotFound,
  SetupNoConnect,
  SetupSaveFailed,
  SetupTimeout,
  SetupHint,
  SetupDoneHint,
  // Setup web page (phone)
  PageChoose,
  PageOther,
  PageConnect,
  PageRescan,
  PageSearching,
  PageTesting,
  PageOk,
  PageTryAgain,
  // Firmware update screen and page
  FirmwareUpdate,
  NotWhileCooking,
  UpdateSignIn,
  UpdateHome,       // printf format, %s = IP address
  UpdateReceiving,  // printf format, %u = percent
  UpdateDone,
  UpdateFailed,     // printf format, %s = reason
  UpdateClosed,
  PageVersion,
  PageFile,
  PageInstall,
  PageUpdateNote,
  PageUpdateOk,
  PageUpdateFailed,
  PageSignIn,
  PageWrongPassword,
  PageBrowserHint,
  // Debug log (Settings -> Debug log) and its download page
  DebugLog,
  Logging,
  DownloadLogs,
  NoSdCard,
  PageNoLogs,
  PageDeleteLogs,
  PageLogsDeleted,
  // About page (Menu -> About)
  About,
  AboutFirmware,
  AboutDate,
  AboutBuild,
  AboutOven,
  AboutOvenModel,
  AboutType,
  AboutENr,
  AboutSerial,
  AboutBoard,
  AboutModel,
  AboutChip,
  AboutCpu,
  AboutFlash,
  AboutPsram,
  AboutDisplay,
  AboutTouch,
  AboutClockChip,
  AboutRelays,
  AboutMagnetron,
  AboutLvgl,
  AboutCore,
  OriginalRelay,
  AboutIp,          // the oven's address on the home network (Wi-Fi connected)
  AboutLastIp,      // ... the last one used (Wi-Fi off)
  AboutMac,
  Connected,
  // Easter eggs (eggs.h)
  EasterEggs,
  EggMelody,
  EggAuthors,
  EggHint,
  Count
};

const char *tr(Str s);
const char *languageName(uint8_t language);  // in its own language, e.g. "Svenska"
