geschwint/AEG_Micromat/(commit log)

2026-10-10 Initial commit: AEG Micromat 143 replacement controller
    Controller sketch (Micromat/) for a Waveshare ESP32-S3-Touch-LCD-2 that
    replaces the original microwave electronics, plus the hardware test sketches
    and project documentation.
    - Micromat/: non-blocking oven state machine, relay outputs with software
    interlocks (magnetron only with door closed and fan running), panel inputs
    (resistor ladder, encoder, pot), LVGL 9 UI with menus (defrost, programs,
    favourites, settings) in English and Swedish, PCF85063A RTC clock with
    optional NTP over Wi-Fi, Wi-Fi setup via a phone and an on-device hotspot,
    Wi-Fi password encrypted with an eFuse-backed key (key not yet created)
    - Test_*/: bring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
    [Micromat.ino, Test_Buzzer.ino, Test_Display.ino, Test_Inputs.ino, Test_LVGL.ino, Test_RTC.ino, Test_Relays.ino]
2026-10-10 Add OTA firmware update over Wi-Fi; fix setup timeouts and service screen
    Firmware update (Settings -> Firmware update, only when the oven is idle):
    - Opens the oven's own hotspot (new shared hotspot module, also used by
    Wi-Fi setup) and, if one is set up, joins the home network.
    - Browser upload page with a password form (random password shown on the
    oven's screen, one-time upload token), plus ArduinoOTA for network upload.
    - Loop watchdog paused during the blocking transfer; a progress hook keeps
    door, oven, outputs, buzzer and display running.
    - Rollback: a new image boots on trial and confirms itself after 30 s of
    normal running, otherwise the next reset returns to the previous o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
    [Micromat.ino, app.cpp, app.h, fw_update.cpp, fw_update.h, hotspot.cpp, hotspot.h, ui.cpp]
2026-10-10 Add a copy of LVGL's lv_conf.h
    LVGL reads its config from Documents\Arduino\libraries\lv_conf.h, outside
    this repo, so a clone couldn't be built without it. Keep a copy in
    config/lv_conf.h (LVGL 9.5.0: C-library malloc, Montserrat fonts, Tiny TTF
    and QR code enabled) and note in CLAUDE.md that the two must be kept in
    sync.
2026-10-11 Add About page with firmware version and hardware details
    Menu -> About (last in the root menu): read-only list scrolled with the
    encoder, in English and Swedish.
    - Firmware version and date (FIRMWARE_VERSION / FIRMWARE_DATE in the new
    about.h, bumped by hand when releasing; __DATE__ is unreliable with the
    build cache), build fingerprint and active OTA slot.
    - The oven's rating plate: AEG Micromat 143E/U, C71A000V ELC 03,
    E-Nr. 947.602 432, S-No 417 10918 (photo AboutTheMicro.jpg added).
    - Controller hardware: board, chip and revision, CPU, flash, PSRAM,
    display, touch, RTC, relay board; LVGL and Arduino core versions.
    Measured values are read at run time.
    - The version is also sho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
2026-10-11 Add README and a build script that stamps firmware images
    - README.md: the project for human readers (what it is, safety, status,
    features, hardware, repository layout, setup, building, installing over
    USB and Wi-Fi, service screen and serial console).
    - tools/build.ps1: the one way to build Micromat. Compiles, then saves the
    deployable image as firmware/Micromat_v<version>_<build date>_<fingerprint>.bin.
    The version comes from about.h; the fingerprint is read from the image's
    app descriptor, so it matches what the oven shows in About, the service
    screen, the update page and the boot log. -Upload also flashes over USB.
    firmware/ stays out of git (*.bin).
    - CLAUDE.md: always bui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
2026-10-11 Power in watts, power view, encoder steps, sleep screen logo, SD debug log
    - Power levels are the original oven's: 750/700/600/500/450/350/250/150/80/0 W,
    shown in watts everywhere. Settings key s3; favourites carried over from s2
    (percent) to the nearest watt step. Presets and defrost moved to watt steps.
    - Turning the power knob shows the watts large for 1 s; any other input
    switches back to the time at once.
    - Encoder steps 5/10/20/30 s and 1 min by the time set (5 min above 1 h),
    with speed-based acceleration.
    - Sleep screen: red AEG logo at the top, clock at the bottom. The logo is now
    an A8 mask coloured red, shared with the splash.
    - Settings -> Debug log: logging to a micro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
2026-10-11 Add German, French and Spanish
    - Three more UI tables (Deutsch, Français, Español), chosen in Settings ->
    Language; the language list now has five entries.
    - Console `texts N` logs every UI text's width with the real fonts, to
    check that translations fit; all five languages checked.
    - Shortened to fit: French/Spanish "door open" in mixed case, some German
    and French hint lines; Swedish "Uppdatering" (the old title was wider than
    the screen) and "Mjukt smör". The splash drops the word "Firmware" if its
    line would be too wide.
    [console.cpp, settings.h, ui.cpp, ui.h, ui_text.cpp, ui_text.h]
2026-10-11 Plan: encoder acceleration checked on the hardware
2026-10-11 eFuse key created; console: mem, wifi checks the saved password
    The Wi-Fi password key was burned on the bench board (BLOCK_KEY0, HMAC_UP)
    with the user's approval. The first attempt aborted inside ESP-IDF before
    writing anything; the docs record that and the verified eFuse state.
    [console.cpp]
2026-10-11 Wi-Fi network setup creates the eFuse key when the board has none
    Settings -> Wi-Fi -> Network now burns the one-time key on a board without
    one (choosing a network is the approval); OTA and log download never need
    it. The burn is checked afterwards (purpose HMAC_UP, read-protected), and
    the eFuse driver's lock is created at start-up with an empty, cancelled
    batch, since creating it during the first keygen once aborted.
    [app.cpp, console.cpp, ui_text.cpp, wifi_creds.cpp, wifi_creds.h]
2026-10-11 Fix crashes from internal RAM running out; add crash report
    malloc() put blocks under 4 KB in internal RAM first, and LVGL's font
    caches could use all of it (504 bytes left after showing every language).
    FreeRTOS locks must be in internal RAM, so the next one created on first use
    got NULL and aborted: the first keygen YES and opening Wi-Fi setup both
    crashed this way. malloc() now tries PSRAM first; ~268 KB internal stays
    free and the Wi-Fi setup's per-open leak is gone.
    The start-up log and the console `crash` command now show the reset reason,
    failed allocations (kept across a crash restart) and the last core dump.
    [Micromat.ino, console.cpp, crash_report.cpp, crash_report.h, wifi_creds.cpp]
2026-10-11 About: Wi-Fi network, state, IP address (or last used) and MAC
    The oven's home-network address is saved at each connection (time sync,
    firmware update, Wi-Fi setup), so About can show it while Wi-Fi is off;
    forgetting or changing the network clears it. Labels checked against the
    widest possible values with `texts` (now also measures sample IP/MAC).
2026-10-11 Release 1.0.0
    Feature-complete on the bench: firmware Micromat_v1.0.0_2026-10-11_1987c560.bin
    (fingerprint 1987c560), to be installed over Wi-Fi. Next: oven inventory and
    installation.
2026-10-11 Document the oven's original boards (safety, power, control) (#1)
    ORIGINAL_HARDWARE.md reverse-engineers the safety/door-switch, power and
    control PCBs from the photos in Original Hardware/ (mirrored solder-side
    overlays and contrast-enhanced copper views in Original Hardware/Overlays/).
    Each item is marked seen, inferred or to be measured, with a measurement
    checklist. Key finding: the power board's logic side and the control board
    are very likely at mains potential.
    HARDWARE.md: magnetron relay K22 identified (Omron G2R-1A-E, 12 VDC coil),
    driven by our own transistor instead of the original one; open questions
    updated. CLAUDE.md points to the new document.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
2026-10-11 Longer done beeps; Wi-Fi icon while a home network is set up (#2)
    - The signal when the timer reaches 00:00 is three 1 s beeps (was 200 ms).
    - Main screen: a Wi-Fi icon (dot and three arcs) left of the magnetron
    icon, shown only while a home network is configured; no icon otherwise.
    The program icon (defrost/preset/favourite) sits left of it, or in its
    place when there is no Wi-Fi icon.
2026-10-11 Version 1.0.1; document versioning and release branches (#3)
    - FIRMWARE_VERSION 1.0.1 (2026-10-12): build bump for the two fixes in
    #2 (longer done beeps, Wi-Fi icon).
    - README.md "Versions and releases" and CLAUDE.md: always increase the
    version with a firmware change (bug fix: build, feature: minor, major
    rework: major); master only via pull requests from feature/bug
    branches; releases are branched off master as releases/<version>.
    [about.h]
2026-10-12 Debug log: keep the start-up lines; the log is always English (1.0.2) (#4)
    * Debug log: keep the start-up lines for the SD card (1.0.2)
    The lines logged before Log.begin() (firmware and build, reset reason,
    crash report, settings) only went to USB: card logging starts once the
    settings are loaded and the card is mounted. They are now kept in a 4 KB
    PSRAM buffer until then; with logging on they go to the card first
    (stamped with the time of the mount), otherwise they are dropped.
    Verified on the bench board with a 16 GB card: after a restart the
    downloaded log starts with "Micromat controller starting (firmware 1.0.2,
    build 4b2ac941, app0)" and the reset reason.
    Docs: the SD card log is te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
    [about.h, debug_log.cpp, debug_log.h, ui.cpp]
2026-10-12 Add a changelog with the history from the start (#5)
    CHANGELOG.md lists what changed in each version (1.0.2, 1.0.1, 1.0.0),
    with fingerprints and pull requests, plus the work done before version
    control, reconstructed from the docs. Sections: Added, Changed, Fixed,
    Documentation; [Unreleased] for documentation-only changes.
    README.md and CLAUDE.md: every pull request updates the changelog.
    README's repository table lists CHANGELOG.md and ORIGINAL_HARDWARE.md.
2026-10-12 License the project under GPL v3; exclude the AEG logo (#6)
    - LICENSE: GNU General Public License v3.0 (official text), copyright
    Stefan Lindberg.
    - README "License": the GPL terms in short, and what isn't covered: the
    AEG name and logo (trademarks; Logo-940x520.avif, logo_aeg.h), the
    embedded Montserrat font (SIL OFL 1.1), and the build libraries.
    The logo header and its generator carry the same note, at the end of
    the file so the 1.0.2 fingerprint (730d4a2c) doesn't change.
    - README: polished "Why" section; the original board uses triacs, not
    SCRs; repository table lists LICENSE, the rating-plate photo and logo.
    - Removed Heatwaves.png and MicrowaveIcons.png (from a web search)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
2026-10-12 Keep the latest release branch at the tip of master (#7)
    Documentation-only changes after a release now move the latest
    releases/<version> branch forward (fast-forward; same firmware and
    fingerprint), so checking out the latest release gives the current docs
    and license too.
    - CHANGELOG: the entries from #5 and #6 (and this one) move from
    Unreleased to 1.0.2 as "Documentation added after the release (same
    firmware 730d4a2c)".
    - README "Versions and releases" and CLAUDE.md: the rule, and where
    documentation-only changelog entries go.
2026-10-14 Easter eggs; outputs really off after a software restart (1.1.0) (#2)
    Easter eggs: with the door open and the oven idle, hold Rotate for 10-14 s
    to open a hidden menu; closing the door then restarts the controller.
    - End melody (kept as a setting, NVS namespace "eggs"): Für Elise instead
    of the three beeps at Done; turned off when a sound setting is saved.
    - Authors (momentary): Geschwint and Claude bounce over the screen.
    - Console: egg, egg melody on|off. Texts in all five languages.
    Fix: Outputs::begin() wrote the OFF level with digitalWrite() before
    pinMode(), which the core ignores, and a software restart keeps the old
    output level. A relay that was on came back on after ESP.restart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
    [Micromat.ino, about.h, app.cpp, app.h, buzzer.cpp, buzzer.h, config.h, console.cpp]
2026-10-15 Done signal always at full volume (1.2.0) (#4)
    * Done signal always at full volume (1.2.0)
    The volume setting now applies to every sound except the signal when the
    time is up: the three beeps, or the end melody (and its preview), always
    play at the loudest step. The next beep or melody goes back to the
    setting. Key clicks, the refused-action beep and the defrost "turn the
    food" beeps follow the setting as before.
    Firmware 1.2.0, fingerprint e17d693a.
    * Changelog: 1.2.0 is pull request #4
    ---------
2026-10-20 The oven's encoder; the encoder push never starts the oven (1.3.0) (#5)
    * Encoder: 4 quadrature steps per click (the oven's encoder)
    The oven's 2-bit quadrature encoder gives 2 pulses per click, a full A/B
    cycle = 4 steps; the bench encoder gives one pulse = 2 steps. Both are
    defined in config.h (ENC_STEPS_ONE_PULSE / ENC_STEPS_TWO_PULSES); the
    oven's is selected. The boot log names the count. Accepted after
    testing over OTA (build 590fe86a).
    * The encoder push never starts the oven (1.3.0)
    On the main screen the push gives the error beep instead of starting a
    set time or resuming a pause; only Quick start starts the oven. The push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
    [about.h, app.cpp, config.h, inputs.cpp]
2026-10-31 Fix the memory leak in the clock: out of memory after ~12 h (1.3.1) (#6)
    Clock::update() read the RTC 4 times a second and converted UTC with
    setenv("TZ", "UTC0") + mktime() + setenv back. newlib's setenv() leaks
    the old string when the value grows (~30 bytes each time), ~190 bytes/s:
    PSRAM and then internal RAM ran out after ~12.25 h of uptime, LVGL's
    LV_ASSERT_MALLOC hung in while(1) and the task watchdog reset the board
    (13 resets in the oven's log, three at an identical uptime, with failed
    allocations and 292 bytes of internal RAM left).
    utcToEpoch() is now a days-from-civil formula (checked against .NET for
    every day 2000-2099); TZ is set once. Garbage months from the RTC make
    the read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
    [Micromat.ino, about.h, clock.cpp, config.h]
2026-11-01 Door left open: sleep with the lamp off; unused time cleared after 30 s (1.4.0) (#7)
    * Door left open: sleep with the lamp off; unused time cleared after 30 s (1.4.0)
    - Door closed and 30 s without use: a time set but not started, or a paused
    cook, goes back to 0 s (Oven::clearUnused(), IDLE_CLEAR_MS), so Quick
    start always means a fresh 30 s.
    - Door left open 2 min without use: asleep in any state and screen (not
    Wi-Fi setup / firmware update), whatever the dim setting, lamp off
    (DOOR_SLEEP_MS, Oven::setLampSleep()). Any use wakes it and turns the
    lamp on again; closing the door wakes it as usual. Replaces the 5 min
    door lamp timeout (LAMP_DOOR_MS).
    - Version 1.4.0, changelog,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
    [about.h, app.cpp, app.h, config.h, oven.cpp, oven.h]
